voretaq7/theremin/README.md

# theremin
A vacuum tube theremin using modern-production tubes
