voretaq7/theremin/kicad/Theremin.kicad_pcb

## KiCad design kicad/Theremin.kicad_pcb (2021-04-10)

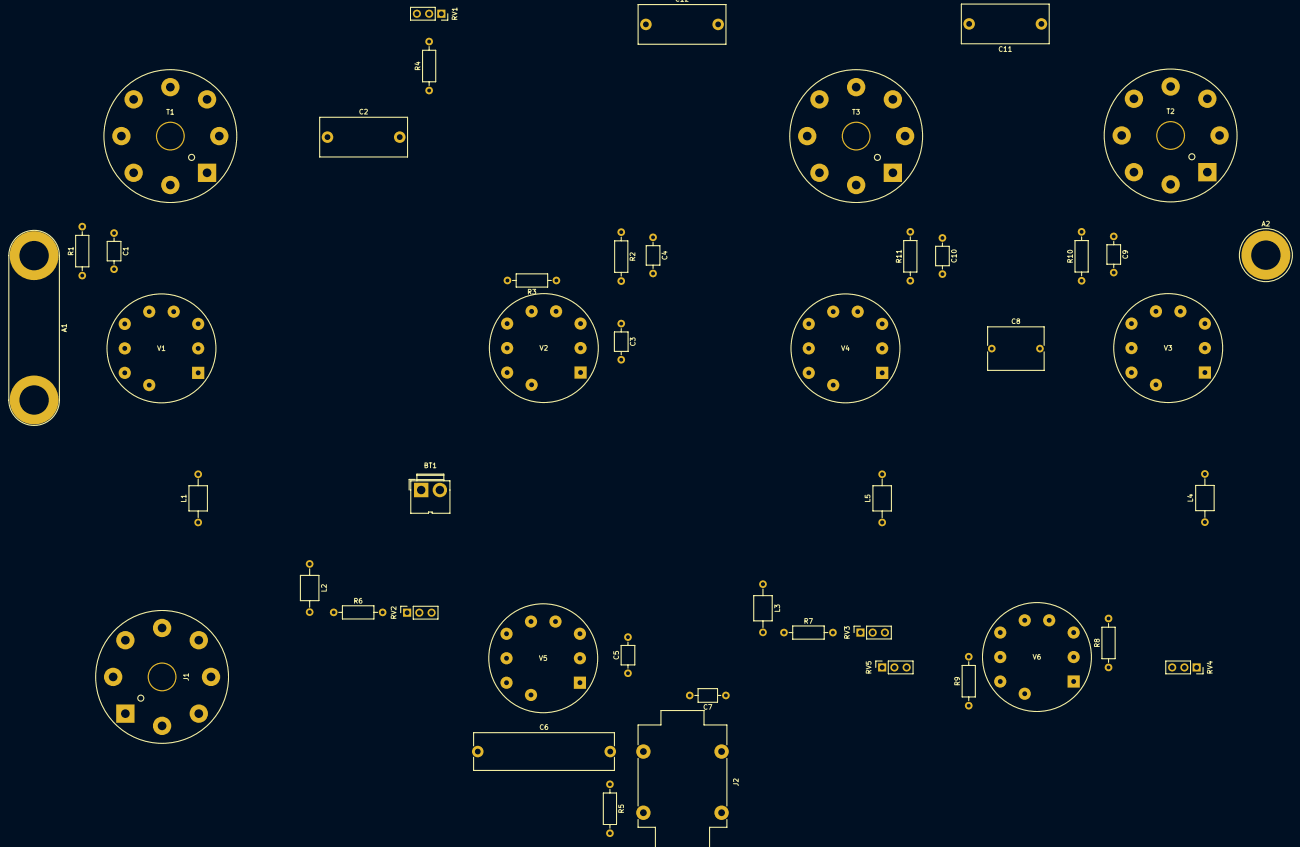
[picture p1: board Theremin.kicad_pcb from above]

Board: 2 copper layers, 47 parts (0 on the bottom side), 36 nets, no tracks yet.

Parts:
A1: Volume_Antenna; Banana_Jack_2Pin
A2: Pitch_Antenna; Banana_Jack_1Pin
BT1: 9V Battery; JWT_A3963_1x02_P3.96mm_Vertical
C1, C9, C10: 50pF; C_Axial_L3.8mm_D2.6mm_P7.50mm_Horizontal
C2, C11, C12: 1-100pF; C_Rect_L18.0mm_W8.0mm_P15.00mm_FKS3_FKP3
C3: 500pF; C_Axial_L3.8mm_D2.6mm_P7.50mm_Horizontal
C4, C5: 250pF; C_Axial_L3.8mm_D2.6mm_P7.50mm_Horizontal
C6: 0.2uF; C_Rect_L29.0mm_W7.6mm_P27.50mm_MKT
C7: 100pF; C_Axial_L3.8mm_D2.6mm_P7.50mm_Horizontal
C8: 1-10pF; C_Rect_L11.5mm_W8.8mm_P10.00mm_MKT
J1: Power_Plug; Valve_Octal
J2: Audio Out; Jack_6.35mm_Neutrik_NMJ4HFD3_Horizontal
L1, L2, L3, L4, L5: L; L_Axial_L5.0mm_D3.6mm_P10.00mm_Horizontal_Murata_BL01RN1A2A2
R1, R10, R11: 1Meg; R_Axial_DIN0207_L6.3mm_D2.5mm_P10.16mm_Horizontal
R2, R4: 5K; R_Axial_DIN0207_L6.3mm_D2.5mm_P10.16mm_Horizontal
R3, R5, R8, R9: 1M; R_Axial_DIN0207_L6.3mm_D2.5mm_P10.16mm_Horizontal
R6, R7: 1K; R_Axial_DIN0207_L6.3mm_D2.5mm_P10.16mm_Horizontal
RV1: 1M; PinSocket_1x03_P2.54mm_Vertical
RV2, RV3: 100K; PinSocket_1x03_P2.54mm_Vertical
RV4: 25K; PinSocket_1x03_P2.54mm_Vertical
RV5: 50K; PinSocket_1x03_P2.54mm_Vertical
T1: Volume Tank; Valve_Octal
T2: VPO Tank; Valve_Octal
T3: FPO Tank; Valve_Octal
V1, V2, V3, V4: ECC83; Valve_Noval_P
V5, V6: EF86; Valve_Noval_P

Connections:
B+1: J1.6, J1.7, L1.1, L4.1, L5.1
B+2: J1.2, J1.3, L2.1, L3.1
C: BT1.2, RV1.3
GND: BT1.1, C2.2, C3.2, C4.2, C5.2, C11.2, C12.2, J1.1, J1.8, J2.S, J2.SN, R3.1, R5.2, R8.2, R9.2, T1.1, T1.2, T2.1, T2.2, T3.1, T3.2, V5.3, V5.7, V5.8, V6.3, V6.7
unnamed: A1.1, T1.4, V1.3, V1.8
unnamed: A1.2, V2.1, V2.2, V2.8
unnamed: A2.1, C9.1, C11.1, R10.2, T2.7, T2.8
unnamed: C1.1, C2.1, R1.2, T1.7, T1.8
unnamed: C1.2, R1.1, V1.2, V1.7
unnamed: C3.1, R2.2, V2.3
unnamed: C4.1, R2.1, RV1.1
unnamed: C5.1, R4.1, V5.1
unnamed: C6.1, RV2.2
unnamed: C6.2, J2.T, J2.TN, R5.1
unnamed: C7.1, RV3.2
unnamed: C7.2, V5.9
unnamed: C8.1, C9.2, R10.1, V3.2, V3.7
unnamed: C10.1, C12.1, R11.2, T3.7, T3.8
unnamed: C8.2, C10.2, R11.1, V4.2, V4.7
unnamed: J1.4, V1.4, V1.5, V2.4, V2.5, V3.4, V3.5, V4.4, V4.5, V5.4, V6.4
unnamed: J1.5, V1.9, V2.9, V3.9, V4.9, V5.5, V6.5
unnamed: L1.2, V1.1, V1.6
unnamed: L2.2, R6.1
unnamed: L3.2, R7.1
unnamed: L4.2, V3.1, V3.6
unnamed: L5.2, V4.1, V4.6
unnamed: R3.2, V2.6, V2.7
unnamed: R4.2, RV1.2
unnamed: R6.2, RV2.1
unnamed: R7.2, RV3.1
unnamed: R8.1, RV4.3, V6.1
unnamed: R9.1, RV5.3, V6.9
unnamed: RV2.3, V5.6
unnamed: RV3.3, V6.6, V6.8
unnamed: RV4.1, RV4.2, T2.5, V3.3, V3.8
unnamed: RV5.1, RV5.2, T3.5, V4.3, V4.8
