voretaq7/theremin/(commit log)

2018-12-18 Initial Commit: Theremin circuit schematics & proposed chassis layouts
2018-12-30 Assembly Prep Changes
    - Modified instrument layout to reflect use of series RC filter for VO output
    - Split power supply & added octal base diagrams to instrument & PSU Schematic
    - Added Bill of Materials (BOM.txt)
2018-12-31 Clean up Power Supply schematic ; Move heaters to Instrument chassis.
    - Removed stray instrument components from PSU schematic
    - Moved heaters to Instrument chassis schematic & connect to power socket
    - Added Standby/On Switch to BOM
    - Added pilot lamp components to BOM
2019-01-24 Change PCB style output jack for solder lug style jack
2019-01-26 Updated schematic & layout with notes from Rockmore & Rosen units
    Power Supply:
    - Filtering with 100 ohm resistors.
    This will produce HV B+ that may need reducing in the
    instrument chassis.
    Instrument:
    - Misc. Cleanups to schematic
    - Finalized layout of components.
2019-01-26 Add 3D Printed insulator collars for C-V100P
2019-02-02 Add diagram of 8-pin tank module
    Pin 1 ---- Capacitor
    Pin 2 ---- Coil Start
    Pin 3 ---- Coil Tap: 10%
    Pin 4 ---- Coil Tap: 25%
    Pin 5 ---- Coil Tap: 33%
    Pin 6 ---- Coil Tap: 50%
    Pin 7 ---- Coil End
    Pin 8 ---- Capacitor
2019-02-23 Add RF shields for FPO & VPO
    Two RF shields are required to prevent excessive coupling of the oscillators
    due to their proximity. These can be any suitable grounded metal shield.
    The shield need not extend past the oscillator tubes (most coupling is at
    the coils) however this was done to prevent tube-to-tube RF coupling.
    Due to proximity to the oscillator coils the sheilds must be rigid
    (movement will affect oscillator frequency & amplitude through capacitive
    changes).
    Due to position of the oscillator coupling capacitor two shields are employed
    (one near each oscillator coil) to match the capacitive effect on both
    oscillators.
    Other layouts may not require shielding (more distance betwe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
2019-03-01 Add connections for pitch oscillators
    - Tank to oscillator driver: 50pf / 1Meg ohm, grid leak through
    coil.
    - Tank to Mixer: Tap off cathode, 100pf isolating cap.
    Construction Note: Mixer grid leak resistors connect to cathode.
    Mixer tube is biased beyond cutoff by negative voltage from
    the oscillator tubes.
2019-03-02 Add Construction & Design note files.
    - Construction Notes includes specific advice on the physical assembly
    of the theremin (component locations, layout, etc.)
    - Design Notes includes the rationale behind certain design choices.
2019-03-02 Update instrument schematic with chokes & cap/resistor values
    - Added RF chokes to plate supplies of mixer tube & all oscillator tubes
    This greatly improves waveform shape and gives better filtering than using
    resistors in the plate supplies.
    - Added feedback capacitors & grid leak resistors for pitch oscillator tanks
    Values should be suitable for 12AX7, 12AY7, 12AT7 or 12AU7 tubes operating
    at 170-185KHz. Higher frequencies should also work.
    - Added feedback circuit for volume oscillator.
    Capacitor value TBD but same value as pitch feedback circuits should work.
    - Added coupling circuit from pitch oscillator cathodes to mixer tube.
2019-11-29 Fall 2019 Update - Pitch section design complete & verified
    BOM: Minor updates, this BOM is incomplete & will be updated.
    Instrument layout & schematics reflowed to put volume loop on
    the left side.
2020-03-10 Add 1Meg bleeder resistor to power supply (B+2)
2020-03-10 Update instrument schematic with final volume control design
    Volume circuit layout should be pretty much finalized.
    Requires external 9V power supply for C- bias
2021-04-10 Update schematics & notes on volume circuit
    Implements a zero-current volume circuit that has been tested
    and provides good dynamics.
2021-04-10 Move Graffle files to Graffle dir & add KiCad schematic/layout
    Decided to sharpen my KiCad skills with this project.
    At the moment both the KiCad and Graffle version of the schematic
    are being kept in sync, but this will likely become a KiCad
    project.
    [Theremin.kicad_pcb, Theremin.sch]
